exiom-xyz/Voron-Mods/README.md

# Exiom's Voron Mods
A repository of my modifications designed for the Voron 2 CoreXY 3D Printer

## Remix / Derivative Work Notice
My modifications are published under the same GPL-3.0 license of the original Voron Design projects my work also derives from.
Feel free to remix and redistribute your derivative work, however it would be much appreciated if you provide credits and link back to this repository.
You can also submit a pull request or send me your remix/related work to be included as part of this repository.
