exiom-xyz/Voron-Mods/CW2_CANBUS_PG9_Umbilical/README.md

# Clockwork 2 CANBUS PG9 Umbilical
Designed for the Voron 2.4 around the [Mellow Fly SB2040](https://s.click.aliexpress.com/e/_DeB9SRr), however it should work for the Trident and similar CANBUS boards which utilizes the Hartk SB PCB mount.

This is an extension to my IMX258 Nozzle Camera mod just without the driver board mounting as I have been doing these 2 mods at the same time.

For Y Endstop Relocation, please see Minsekt's [Y Endstop Relocation Mod](https://github.com/VoronDesign/VoronUsers/tree/master/printer_mods/Minsekt/Rear_Umbilical/Y_Endstop_Relocation)

### Coming Soon!
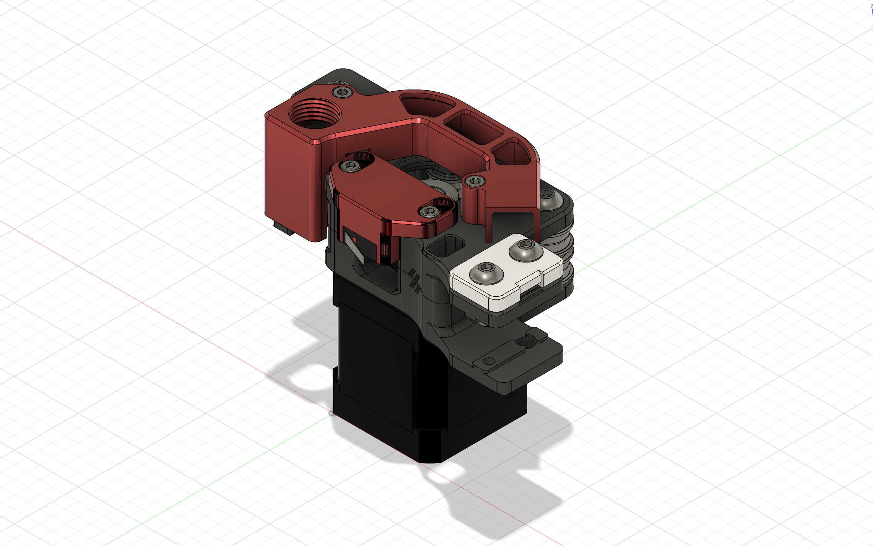
[picture p1: CW2_CANBUS_PG9_Umbilical/Showroom/PG9_Umbilical_Cable_Cover.png]
