exiom-xyz/Voron-Mods/IMX258_Nozzle_Camera/STL/CW2_Cable_Anchors/README.md

# Clockwork 2 Cable Anchors
> :sparkle:See [my umbilical mod](https://github.com/exiom-xyz/Voron-Mods/tree/main/CW2_CANBUS_PG9_Umbilical), for the matching PG9 Cable Cover for the A Drive.:sparkle:

Cable Chain version:<br>


Umbilical version:<br>
(Designed for implementations utilizing the SB PCB or similar boards such as the SB2040)<br>
