exiom-xyz/Voron-Mods/IMX258_Nozzle_Camera/STL/ADXL345+Camera_Combo_Mount/README.md

# ADXL345+Camera Combo Mount
