exiom-xyz/Voron-Mods/CW2_CANBUS_PG9_Umbilical/STL/[a]_Exiom_PG9_Cable_Cover_r2.stl

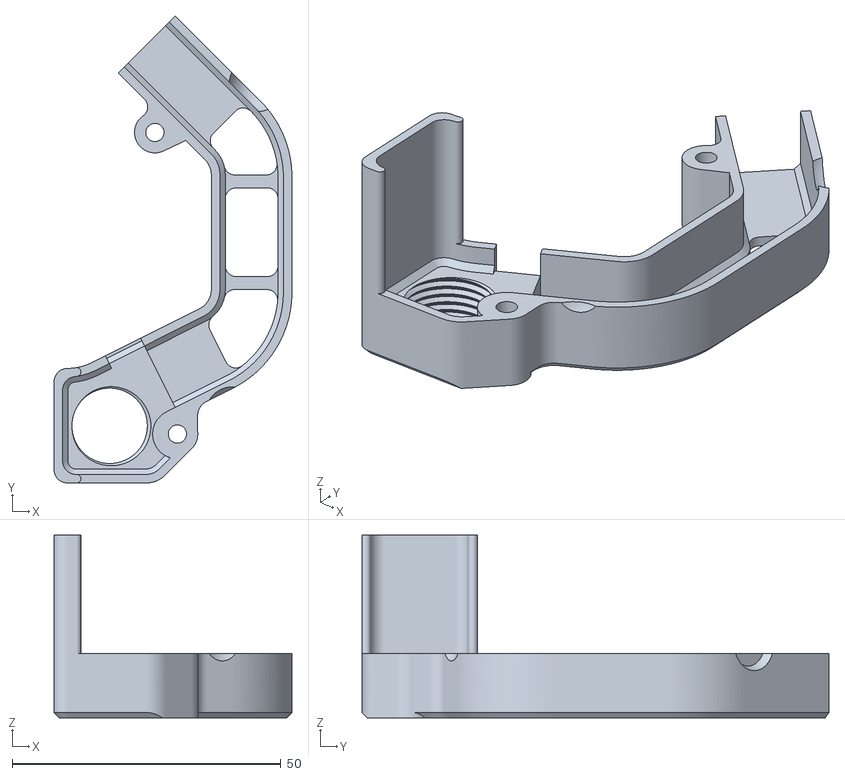
[picture p8: CAD file, 2023-02-14]
CW2_CANBUS_PG9_Umbilical/STL/[a]_Exiom_PG9_Cable_Cover_r2.stl
44.2 x 86.8 x 34.0
