exiom-xyz/Voron-Mods/IMX258_Nozzle_Camera/STL/ADXL345+Camera_Combo_Mount/Generic-ADXL+Camera_Combo_Mount_r3.stl

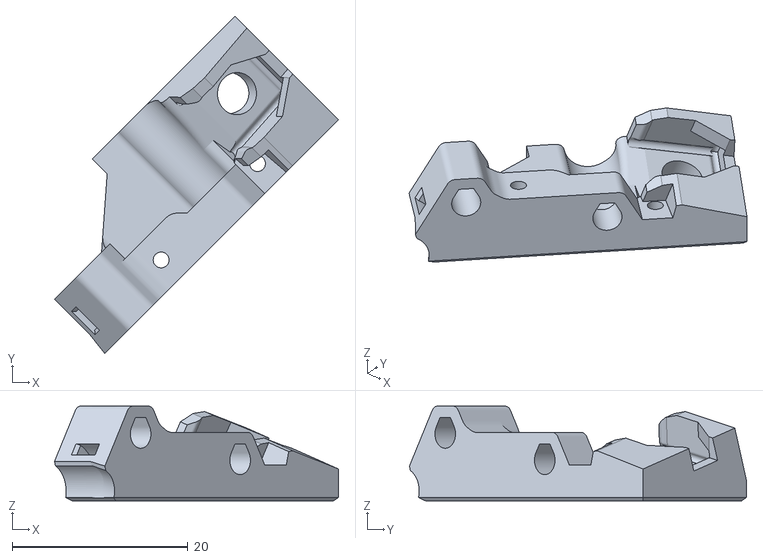
[picture p9: CAD file, 2023-02-13]
IMX258_Nozzle_Camera/STL/ADXL345+Camera_Combo_Mount/Generic-ADXL+Camera_Combo_Mount_r3.stl
32.3 x 38.3 x 10.8
