exiom-xyz/Voron-Mods/IMX258_Nozzle_Camera/STL/CW2_Cable_Anchors/Exiom_PG9_17mm_motor_Umbilical_Anchor_r2_with_relief.stl

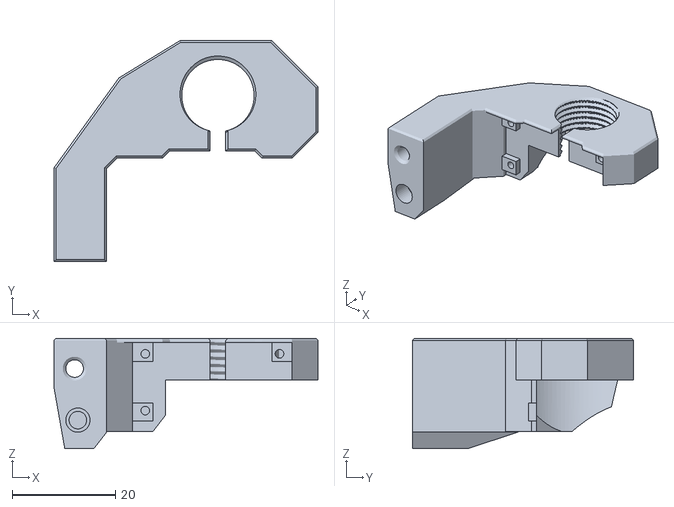
[picture p11: CAD file, 2023-05-26]
IMX258_Nozzle_Camera/STL/CW2_Cable_Anchors/Exiom_PG9_17mm_motor_Umbilical_Anchor_r2_with_relief.stl
51.2 x 42.9 x 21.4
