exiom-xyz/Voron-Mods/IMX258_Nozzle_Camera/STL/CW2_Cable_Anchors/Exiom_PG7_Umbilical_Anchor_r3_with_relief.stl

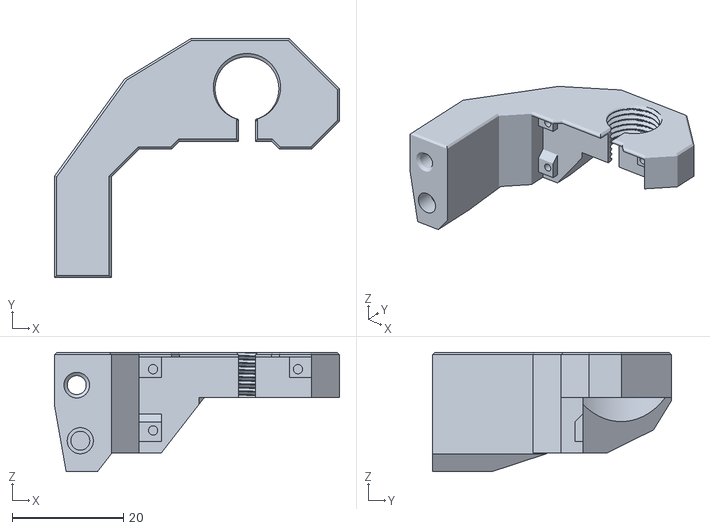
[picture p12: CAD file, 2023-05-25]
IMX258_Nozzle_Camera/STL/CW2_Cable_Anchors/Exiom_PG7_Umbilical_Anchor_r3_with_relief.stl
51.2 x 42.9 x 21.4
