exiom-xyz/Voron-Mods/IMX258_Nozzle_Camera/STL/CW2_Cable_Anchors/Exiom_PG9_19mm_motor_Umbilical_Anchor_r1.stl

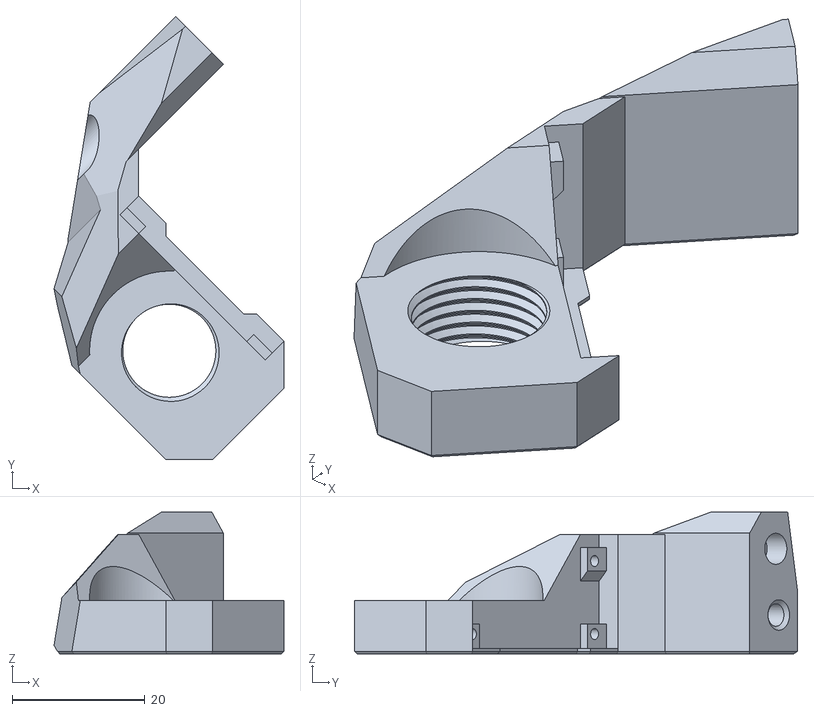
[picture p13: CAD file, 2023-02-13]
IMX258_Nozzle_Camera/STL/CW2_Cable_Anchors/Exiom_PG9_19mm_motor_Umbilical_Anchor_r1.stl
34.6 x 66.7 x 21.4
