exiom-xyz/Voron-Mods/IMX258_Nozzle_Camera/STL/CW2_Cable_Anchors/Exiom_2-Hole_Chain_Anchor_r1.stl

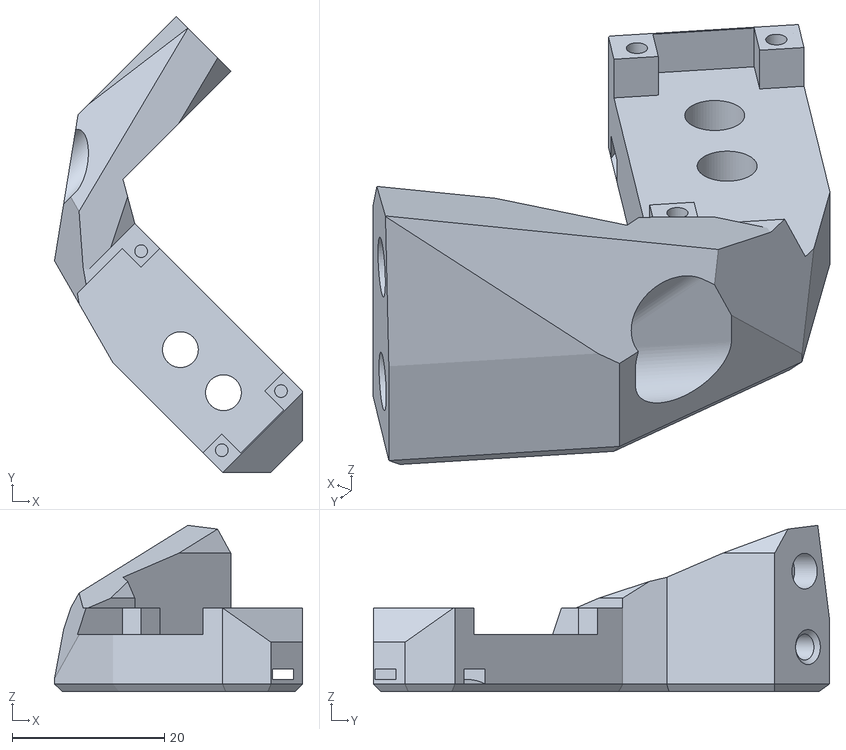
[picture p14: CAD file, 2023-02-13]
IMX258_Nozzle_Camera/STL/CW2_Cable_Anchors/Exiom_2-Hole_Chain_Anchor_r1.stl
32.6 x 59.9 x 21.9
