exiom-xyz/Voron-Mods/CW2_CANBUS_PG9_Umbilical/CANBUS_Umbilical_Build.md

# CANBUS Umbilical Build Guide 
> :bangbang:**THIS PROJECT IS CURRENTLY IN PRE-RELEASE/BETA, DOCUMENTATION IS NOT COMPLETE!**:bangbang:
> **<BR>:bangbang:CHECK BACK REGULARLY FOR THE LATEST UPDATES/INFORMATION!**:bangbang:
