exiom-xyz/Voron-Mods/(commit log)

2023-02-10 CAD Demo Upload
2023-02-13 Initial Public Release
    [Exiom_2-Hole_Chain_Anchor_r1.stl, Exiom_PG9_Umbilical_Anchor.stl, Generic-ADXL+Camera_Combo_Mount_r3.stl]
2023-02-14 renamed for consistency
    [Exiom_PG9_Umbilical_Anchor_r1.stl]
2023-02-14 PG9 Cable Cover Revision 2
    [[a]_Exiom_PG9_Cable_Cover_r1.stl, [a]_Exiom_PG9_Cable_Cover_r2.stl]
2023-05-12 Create Exiom_PG7_Umbilical_Anchor_r1.stl
    Publish Exiom_PG7_Umbilical_Anchor_r1
    [Exiom_PG7_Umbilical_Anchor_r1.stl]
2023-05-25 Revised PG7 Umbilical Anchor
    Revised PG7 Umbilical Anchor to prevent Z Chain collision
    [Exiom_PG7_Umbilical_Anchor_r1.stl, Exiom_PG7_Umbilical_Anchor_r2.stl]
2023-05-25 Added Cable Relief for PG7 Anchor
    [Exiom_PG7_Umbilical_Anchor_r2.stl, Exiom_PG7_Umbilical_Anchor_r3.stl]
2023-05-26 Additional Revision on CW2 Anchors
    Additional Revision for different motor sizes and added relief
    [Exiom_PG7_Umbilical_Anchor_r3_with_relief.stl, Exiom_PG9_17mm_motor_Umbilical_Anchor_r2.stl, Exiom_PG9_17mm_motor_Umbilical_Anchor_r2_with_relief.stl, Exiom_PG9_19mm_motor_Umbilical_Anchor_r1.stl]
